henrydatei/cartpole-swingup-rl/latex/input/related_work.tex

\chapter{Background and Literature Review}

\section{Fundamentals of Reinforcement Learning}

Reinforcement learning (RL) is a type of machine learning where an agent learns to make decisions by taking actions in an environment to maximize cumulative reward. This approach is inspired by behaviorist psychology, where learning is achieved through interactions with the environment and is reinforced by rewards and punishments. RL has gained significant attention due to its successful applications in various domains such as robotics, game playing, and autonomous systems (\cite{sutton_reinforcement_2018}).

The fundamental concepts of reinforcement learning are as follows:
\begin{itemize}
    \item Agent and Environment: In RL, the learning process involves an agent and an environment. The agent interacts with the environment by performing actions, and the environment responds by providing feedback in the form of rewards or penalties. The objective of the agent is to learn a policy that maximizes the total reward over time (\cite{sutton_reinforcement_2018}).
    \item State ($S$): Represents the current situation or configuration of the environment.
    \item Action ($A$): The set of all possible moves the agent can make.
    \item Reward ($R$): The feedback from the environment based on the action taken by the agent.
    \item Policy ($\pi$): A policy is a strategy used by the agent to decide the next action based on the current state.
    \item Value Function ($V$): The value function estimates the expected return (total reward) starting from a state and following a particular policy. It helps in evaluating the goodness of states (\cite{szepesvari_algorithms_2022}).
    \item Model-Free RL: The agent learns a policy or value function without understanding the underlying model of the environment. Examples include Q-Learning (\cite{watkins_q-learning_1992}) and PPO (\cite{pan_policy_2018}).
    \item Model-Based RL: The agent learns a model of the environment (transition probabilities and reward function) and uses it to plan actions (\cite{kaelbling_reinforcement_1996}).
\end{itemize}

The key algorithms in reinforcement learning include:
\begin{itemize}
    \item Dynamic Programming: Dynamic programming (DP) methods require a complete model of the environment. They are used to compute optimal policies by iteratively improving value functions. Examples include Policy Iteration and Value Iteration.
    \item Monte Carlo (MC) methods learn directly from episodes of experience. They do not require knowledge of the environment's model and estimate value functions based on sample returns.
    \item Temporal-Difference (TD) learning combines ideas from DP and MC methods. It updates value estimates based on the difference between consecutive estimates (\cite{sutton_reinforcement_2018}).
\end{itemize}

One of the central challenges in RL is the trade-off between exploration (trying new actions to discover their effects) and exploitation (choosing actions that are known to yield high rewards). Various strategies such as $\varepsilon$-greedy, softmax, and Upper Confidence Bound (UCB) are employed to balance this trade-off (\cite{auer_finite-time_2002}).

With the advent of deep learning, RL has evolved into deep reinforcement learning (DRL), where neural networks are used to approximate value functions or policies. Notable advancements include:
\begin{itemize}
    \item Deep Q-Network (DQN): Combines Q-Learning with deep neural networks to handle high-dimensional state spaces, such as those in Atari games (\cite{mnih_human-level_2015}).
    \item Actor-Critic Methods: Use two neural networks, one for the policy (actor) and one for the value function (critic). Examples include A3C (Asynchronous Advantage Actor-Critic) and PPO (Proximal Policy Optimization) (\cite{mnih_asynchronous_2016,schulman_proximal_2017}).
\end{itemize}

The state-of-the-art algorithm is Proximal Policy Optimization (PPO) which is a model-free, on-policy algorithm that optimizes the policy by maximizing the expected return. It uses a clipped surrogate objective to prevent large policy updates and ensure stable learning. PPO has been successfully applied to a wide range of tasks, including robotic manipulation, locomotion, and game playing. It combines the benefits of policy gradient methods with the stability of trust region methods and is implemented in the OpenAI Baselines library (\cite{schulman_proximal_2017,openai_proximal_2017,wouter_van_heeswijk_proximal_2023}).

\section{The Cart-Pole Problem and Swing-Up Dynamics}

The cart-pole problem, often referred to as the inverted pendulum, is a classic benchmark in control theory and reinforcement learning. It involves a pole attached to a cart that moves along a frictionless track. The goal is to balance the pole upright by applying forces to the cart. This problem has been extensively studied because it embodies the fundamental challenges of dynamic stability and control like nonlinearity and instability (\cite{kumari_root_2023}).

The cart-pole system consists of a cart of mass $m_c$ and a pole of length $l$ and mass $m_p$. The cart can move horizontally, and the pole is free to swing in the vertical plane. The system's state can be described by four variables: the cart's position $x$, the cart's velocity $\dot{x}$, the pole's angle $\theta$ from the vertical, and the pole's angular velocity $\dot{\theta}$.

The equations of motion for the cart-pole system are derived from Newton's laws of motion and can be expressed as follows (assuming no friction):
\begin{align}
\ddot{\theta} &= \frac{g\sin\theta + \cos\theta\left(\frac{-F-m_p l \dot{\theta}^2 \sin\theta}{m_c+m_p}\right)}{l\left(\frac{4}{3}-\frac{m_p \cos^2 \theta}{m_c+m_p}\right)} \notag \\
\ddot{x} &= \frac{F+m_p l (\dot{\theta}^2 \sin\theta - \ddot{\theta} \cos\theta)}{m_c+m_p} \notag
\end{align}
where $F$ is the force applied to the cart, and $g$ is the acceleration due to gravity. These equations are coupled and nonlinear, posing a significant challenge for control (\cite{florian_correct_2007}).

While balancing the pole is a standard control problem, the swing-up task involves bringing the pole from a hanging downward position to an upright position and then stabilizing it. The swing-up problem is more complex because it requires controlling the system to pass through a large range of states.

One popular method for solving the swing-up problem is based on energy control. The idea is to apply forces to the cart to increase the total energy of the system to the desired level that allows the pole to be balanced upright. The total energy $E$ of the system is the sum of the kinetic and potential energies:
\begin{align}
E = \frac{1}{2} m_c \dot{x}^2 + \frac{1}{2} m_p (\dot{x}^2 + l^2 \dot{\theta}^2 + 2 l \dot{x} \dot{\theta} \cos(\theta)) + m_p g l \cos(\theta) \notag
\end{align}
The control strategy involves applying a force $F$ to the cart that drives the system's energy towards the desired energy level for the upright position. When the pole's energy is close to the required level, a switching strategy can be employed to transition from swing-up control to balance control (\cite{astrom_swinging_2000}).

\section{Solution Approaches for the Cart-Pole Problem}

Several notable solution approaches have been applied to the Cart-Pole problem, utilizing various control algorithms as highlighted by Kumari and Agarwal (\citeyear{kumari_root_2023}). These include:
\begin{itemize}
    \item PID Controller
    \item Reinforcement Learning
    \item Linear Quadratic Regulator (LQR) Controller
    \item Lyapunov-based Controller
    \item Particle Swarm Optimized Controller
    \item Fuzzy Controller
    \item Sliding Mode Controller
\end{itemize}

These approaches are often combined to achieve optimal results. Furthermore, an exemplary paper is introduced which demonstrates the application of each approach.

\subsection{PID Controller}

The Proportional-Integral-Derivative (PID) controller is a control strategy where the control signal at time $t$ is the sum of the proportional, integral, and derivative components. All three components respond to the error $e_t$, which is the difference between the desired and the actual state:
\begin{itemize}
    \item Proportional (P) Component: Reacts proportionally to the current error.
    \item Integral (I) Component: Responds to the accumulated sum of past errors.
    \item Derivative (D) Component: Reacts to the rate of change of the error.
\end{itemize}
For discrete time, the control signal is given by:
\begin{align}
    u_t = K_P\cdot e_t + K_I\cdot\sum_{i=0}^t e_i + K_D\cdot\frac{e_t - e_{t-1}}{\Delta t} \notag
\end{align}
In continuous time, the derivative term is replaced by the derivative, and the summation term by the integral. The values of $K_P$, $K_I$, and $K_D$ are referred to as the \textit{gains} and are determined through manual tuning or optimization.

Chang and Lee (\citeyear{chang_design_2007}) used three PID controllers: one for the swing-up phase, one for stabilizing the pendulum's angle when it is within $\pm 14^\circ$, and one for balancing the pendulum when it is within $\pm 3^\circ$. The second phase enhances the system's robustness by utilizing Feedback Linearization Control to linearize the nonlinear system. The core idea behind Feedback Linearization Control is to transform the nonlinear system
\begin{align}
    \dot{x} = f(x) + g(x)\cdot u \notag
\end{align}
where $x$ is the state vector, $u$ is the control input, and $f$ and $g$ are nonlinear functions describing the system dynamics. The system is linearized by transforming the control input and introducing a new control signal $v$:
\begin{align}
    u = \frac{1}{g(x)}(v - f(x)) \notag
\end{align}
This results in a linearized system $\dot{x} = v$, which can then be controlled using linear controllers like PID or LQR (\cite{slotine_applied_1991}, p. 208ff).

Comparative studies, such as those by Prasad et al. (\citeyear{prasad_optimal_2011}) and Varghese et al. (\citeyear{varghese_optimal_2017}), have compared PID controllers with other control techniques, frequently in combination with LQR. These studies conclude that while PID performs well, other controllers tend to outperform it. Both studies used MATLAB Simulink for simulations, with a time step of 0.01 seconds and a maximum simulation period of 10 seconds. The system typically reaches equilibrium after approximately 7 seconds. The state-space equations with disturbance input are:
\begin{align}
    \dot{x} &= \frac{\mathrm{d}}{\mathrm{d}t}\begin{pmatrix}
        \theta \\
        \dot{\theta} \\
        z \\
        \dot{z}
    \end{pmatrix} = \begin{pmatrix}
        \dot{\theta} \\
        f_1 \\
        \dot{z} \\
        f_2
    \end{pmatrix} \notag \\
    y &= Cx \notag \\
    f_1 &= \frac{u\cos(\theta) - (M+m)g\sin(\theta) + ml(\cos(\theta)\sin(\theta))\dot{\theta}^2 - \frac{M}{m}F_w\cos(\theta)}{ml\cos^2(\theta) - (M+m)l} \notag \\
    f_2 &= \frac{u + ml(\sin(\theta))\dot{\theta}^2 - mg\cos(\theta)\sin(\theta) + F_w\sin^2(\theta)}{M+m-m\cos^2(\theta)} \notag
\end{align}
where $z$ is the cart position, $\theta$ is the pendulum angle, $M$ is the cart mass, $m$ is the pendulum mass, $l$ is the length of the pendulum, $g$ is gravitational acceleration, $F_w$ represents wind disturbance, and $u$ is the control force applied to the cart. Both studies used two PID controllers: one controlling the cart's position towards the center, and the other balancing the pendulum. The wind disturbance was simulated using a white noise signal.

\subsection{Reinforcement Learning}

For an overview of the theory behind reinforcement learning (RL), refer to the previous section. RL is a technique in which an agent learns to select actions through interactions with the environment to maximize a cumulative reward. By interacting with the environment, the agent gains experience and adjusts its strategy to optimize the reward. To reduce the effort required for modeling the environment, model-free RL is commonly employed, where the agent learns directly from experiences without explicitly modeling the environment.

There are only a few papers that utilize a real cart-pole system for the swing-up task (e.g., \cite{nayante_reinforcement_2021, pilcolearner_cart-pole_2011, deisenroth_pilco_2011}); most studies use simulated environments, often without addressing the swing-up task, and employ similar reward functions (e.g., \cite{kumar_balancing_2020, liu_swing-up_2023, kimura_stochastic_1999}). Various approaches to reward functions are discussed in the Experimental Setup section. Notably, only one recent paper was found that uses a real cart-pole system for the swing-up task, although it applies a simple reward function (\cite{nayante_reinforcement_2021}).

I chose to continue my work with the reinforcement learning (RL) controller due to its unique challenge and potential in real-world applications. Unlike other control strategies, where multiple papers have successfully demonstrated both swing-up and balancing of the pole in real-world scenarios, only one study using an RL-based approach has managed to accomplish this (\cite{nayante_reinforcement_2021}). The limited number of real-world implementations highlights the complexity of applying RL to physical systems, yet it also presents an opportunity for further exploration and innovation. By advancing this line of research, I aim to contribute to the development of RL controllers capable of performing both swing-up and stabilization in practical, real-world environments.

\subsection{LQR Controller}

The Linear Quadratic Regulator (LQR) was introduced by Kalman (\citeyear{kalman_contributions_1960}) and is optimal for linear systems with quadratic cost functions. The dynamics of a linear system are given by:
\begin{align}
    \dot{x} = Ax + Bu \notag
\end{align}
where $x$ is the state vector, $u$ is the control input, and $A$ and $B$ are system matrices. The cost function is defined as:
\begin{align}
    J = \int_0^\infty (x^T Q x + u^T R u) \,\mathrm{d}t \notag
\end{align}
where $Q$ and $R$ are weighting matrices. The goal of LQR is to minimize this cost function by choosing the control law $u = -Kx$, where $K$ is the regulator matrix, ensuring system stability. The matrix $K$ is found by solving the Riccati equation:
\begin{align}
    A^T P + PA - PBR^{-1}B^T P + Q = 0 \notag
\end{align}
Once the solution $P$ is obtained, the regulator matrix $K$ is calculated as:
\begin{align}
    K = R^{-1}B^T P \notag
\end{align}
Solving the Riccati equation guarantees that the regulator stabilizes the system (as long as the system $(A, B)$ is stabilizable) and minimizes the cost function.

Kumar and Jerome (\citeyear{vinodh_kumar_robust_2013}) applied this approach. After analyzing their system, they determined the following system matrices:
\begin{align}
    A &= \begin{pmatrix}
        0 & 0 & 1 & 0 \\
        0 & 0 & 0 & 1 \\
        0 & \frac{(M_pl)^2}{q} & \frac{-B_{eq}(M_pl^2 + I)}{q} & \frac{M_plB_p}{q} \\
        0 & \frac{(M+M_p)M_pgl}{q} & \frac{M_plB_{eq}}{q} & \frac{(M+M_p)B_p}{q}
    \end{pmatrix} \notag \\
    B &= \begin{pmatrix}
        0 \\
        0 \\
        \frac{M_pl^2+I}{q} \\
        \frac{M_pl}{q}
    \end{pmatrix} \notag \\
    x &= \begin{pmatrix}
        z \\
        \theta \\
        \dot{z} \\
        \dot{\theta}
    \end{pmatrix} \notag
\end{align}
Here, $M_p$ and $l$ are the mass and length of the pendulum, $M$ is the mass of the cart, $I$ is the moment of inertia of the pendulum, $B_{eq}$ is the equivalent damping constant, $B_p$ is the pendulum damping constant, $g$ is gravitational acceleration, $z$ is the cart position, and $\theta$ is the pendulum angle. The term $q$ is defined as: $q = (M+M_p)(I+M_pl^2) - (M_pl)^2$. With the following weighting matrices:
\begin{align}
    Q &= \begin{pmatrix}
        0.5 & 0 & 0 & 0 \\
        0 & 5.5 & 0 & 0 \\
        0 & 0 & 0 & 0 \\
        0 & 0 & 0 & 0
    \end{pmatrix} \notag \\
    R &= \begin{pmatrix}
        0.0003
    \end{pmatrix} \notag
\end{align}
the regulator matrix $K$ is found to be:
\begin{align}
    K = \begin{pmatrix}
        -44.72 & 200.8 & -49.77 & 27.38
    \end{pmatrix} \notag
\end{align}
for the system that Kumar and Jerome built in their laboratory. The system reaches equilibrium after approximately 7 seconds.

\subsection{Lyapunov-based Controller}

Lyapunov-based control is a method used to design controllers that ensure system stability by employing Lyapunov functions. A Lyapunov function is a scalar function that quantifies the system's energy and is used to assess its stability. The Lyapunov function is chosen such that its derivative along the system's trajectories is negative definite, guaranteeing that the system converges to a stable equilibrium point. (\cite{slotine_applied_1991}).

Kai and Bito (\citeyear{kai_new_2014}) combined a Lyapunov function with an LQR controller to solve the Cart-Pole problem through simulation. Additionally, they used discrete mechanics, which present fewer numerical errors while preserving some physical laws and allowing for larger sampling times (\cite{marsden_discrete_2001}). Their method successfully balanced the pole upright after 3.2 seconds. The Lyapunov function they used is:
\begin{align}
    V_k = w_1E_k^2 + w_2\left((\cos\theta_k-1)^2 + \sin^2\theta_k\right) + w_3(\theta_{k-1} - \theta_k)^2 + w_4z_k^2 \notag
\end{align}
where $w_1, w_2, w_3, w_4 > 0$ are weights, $\theta_k$ is the angle of the pole at time step $k$, $z_k$ is the position of the cart at time step $k$, and $E_k$ is a discrete energy-like function defined as:
\begin{align}
    E_k = \frac{1}{2}ml^2\left(\frac{\theta_k - \theta_{k-1}}{h}\right)^2 + mgl[\cos((1-\alpha)\theta_{k-1} + \alpha\theta_k) - 1] \notag
\end{align}
where $m$ is the mass, $l$ is the length of the pendulum, and $h$ is the sampling interval. The parameter $\alpha$ is a weighting factor between consecutive angles. A correction function $\Gamma(\theta_{k+1}, u_k)$ is introduced, which becomes zero when the optimal control input $u_k$ and the next state $\theta_{k+1}$ are substituted:
\begin{align}
    \Gamma(\theta_{k+1}, u_k) = V_{k+1} - V_k + p(\theta_k - \theta_{k-1})^2 = 0 \notag
\end{align}
Here, $p$ is a weight, and the Lyapunov function $V_k$ depends on the system state, thereby indirectly depending on $u_k$. Using the Newton method and the following update rule:
\begin{align}
    u_{k}^{l+1} = u_k^l - \frac{\partial\Gamma}{\partial u_k}^{-1}\Gamma \notag
\end{align}
the optimal control input $u_k$ is iteratively found. For stabilization, the LQR controller is activated when the pendulum's angle reaches $\frac{\pi}{4}$ radians.

\subsection{PSO Controller}

The tuning of controller parameters is often performed through trial and error or optimization algorithms. One such optimization algorithm is Particle Swarm Optimization (PSO). PSO was introduced by James Kennedy and Russell Eberhart in 1995, inspired by the social behavior of birds flocking or fish schooling. The core idea of PSO is to simulate the social dynamics of a group of individuals, called particles, that collaboratively search for the optimal solution to a problem. In this algorithm, each particle represents a potential solution. These particles move through the solution space and adjust their positions based on their own experiences and the experiences of neighboring particles (\cite{kennedy_discrete_1997}). Each particle has a position and a velocity, which are iteratively updated based on three key influences: the particle's current position, its personal best position, and the global best position discovered by the swarm (\cite{eberhart_new_1995}).

Initially, a swarm of particles is randomly positioned within the search space, and their velocities are randomly assigned (\cite{shi_parameter_1998}). The fitness of each particle, indicating its closeness to the optimal solution, is evaluated using an objective function. To improve their positions, particles update their velocities by considering three factors: their inertia (current velocity), the cognitive influence (direction towards their personal best position), and the social influence (direction towards the global best position) (\cite{eberhart_new_1995}). These updates guide the particles' movement through the solution space, and over time, they converge towards better solutions. Each particle's personal best is updated whenever it finds a better position, and the global best is updated if any particle discovers a new overall best position. This process repeats until a stopping criterion is met, such as reaching a maximum number of iterations or finding a sufficiently good solution (\cite{angeline_evolutionary_1998}). Random factors are included to introduce variability into the search, while certain parameters control the strength of the pull towards the personal and global best positions (\cite{ozcan_analysis_1998}).

Mousa et al. (\citeyear{mousa_stabilizing_2015}) compared a PI controller with LQR against a PI controller optimized using PSO and found that the PSO-optimized PI controller outperformed the PI+LQR controller. In their simulations, the pendulum balanced in 6 seconds with the PI+LQR controller, while it balanced in only 4 seconds using the PSO-optimized PI controller.

\subsection{Fuzzy Controller}

A fuzzy logic controller is a type of control system that uses fuzzy logic, instead of traditional binary logic, to handle uncertain, imprecise, or ambiguous data. Unlike conventional controllers that rely on precise inputs and mathematical models, a fuzzy logic controller mimics human decision-making by interpreting inputs in a way that resembles natural language reasoning (\cite{rehman_introduction_2017}). This makes it particularly useful for complex systems where exact mathematical models are difficult to derive, or where control needs to manage vagueness.

The basic operation of a fuzzy logic controller involves three main stages: fuzzification, inference, and defuzzification. In the fuzzification stage, precise input values are converted into fuzzy sets. These sets represent linguistic variables like \textit{low}, \textit{medium}, or \textit{high}, using membership functions that define the degree to which a particular input belongs to each category (\cite{liu_real-time_2009}).

The next stage is the inference process, where fuzzy sets are applied to a set of if-then rules to determine the control action. These rules are based on expert knowledge and are expressed in simple, human-like terms (\cite{dahiya_introduction_2016}). Multiple rules can be applied simultaneously, and the system combines them to determine the most appropriate control output.

In the final stage, defuzzification, the fuzzy results from the inference process are converted back into precise values to produce a specific control action (\cite{mahmoud_basics_2018}, pp. 15ff).

Nour et al. (\citeyear{nour_fuzzy_2007}) employed a fuzzy logic controller to balance a simulated Cart-Pole system. In their setup, the pole starts in the upright position and is only destabilized by external disturbances. The control objective is to move the cart in such a way that the pole returns to its upright position. The fuzzy logic controller was compared with a PID controller, showing superior performance. Specifically, the PID controller's parameters were optimized for one set of system parameters (1-kilogram cart, 100-gram pole), but when applied to a system with different parameters, the fuzzy logic controller demonstrated greater robustness. For their fuzzy logic controller, they defined 5 fuzzy sets for the pole's angle, 5 fuzzy sets for the angular velocity, 2 fuzzy sets for the cart's position and velocity, and 13 fuzzy sets for the force to be applied to the cart. A total of 225 rules were established to determine the force, based on the following formula and the fuzzy sets into which the input values fall:
\begin{align}
    F = \theta + (\dot{\theta}-1) + (-x+3) + (-\dot{x}+3) \notag
\end{align}
In a subsequent step, the number of rules was reduced to 16, with only 2 fuzzy sets (positive or negative) for each of the 4 inputs. This reduction in rule complexity decreased the computation time while still providing satisfactory results.

\subsection{Sliding Mode Controller}

A sliding mode controller (SMC) is a nonlinear control method designed to drive a system's state to a predefined surface, called the sliding surface, and to keep it on that surface indefinitely. This control strategy is particularly effective for systems with uncertainties or disturbances, as it offers robust performance by switching the control law based on the system's state (\cite{edwards_sliding_1998}).

The operation of an SMC is divided into two phases: the reaching phase and the sliding phase (\cite{uswarman_robust_2019}). In the reaching phase, the controller drives the system's state to the sliding surface. Once the state reaches the surface, the sliding phase begins, during which the system state moves along the surface to the desired equilibrium point. The sliding surface is designed such that the system's behavior on the surface satisfies the control objectives (\cite{maarif_sliding_2022}).

A key feature of SMC is its robustness to disturbances and model uncertainties. This robustness arises because, once the system enters the sliding mode, the dynamics are governed by the sliding surface, making them independent of certain types of disturbances or parameter variations. However, the switching behavior of the control signal can result in a phenomenon called chattering, where rapid switching of the control signal occurs, which can be undesirable in practical applications. To mitigate chattering, various techniques, such as introducing a boundary layer around the sliding surface, are employed to smooth the control actions (\cite{chalanga_output_2019}).

Mathematically, the control law in SMC typically includes a discontinuous component that switches the control action depending on the system's position relative to the sliding surface (\cite{mahmoud_optimizing_2021}). The design of the sliding surface is critical, as it directly impacts the system's performance during the sliding phase.

Ma'arif et al. (\citeyear{maarif_backstepping_2022}) extended this controller using the backstepping technique, which divides a complex system into subsystems. Their simulation focused only on balancing the pendulum and did not include the swing-up phase. They used the following nonlinear model:
\begin{align}
    \dot{\theta} &= f(x,t) + g(x,t)u + d(x,t) \notag
\end{align}
where $\theta$ is the pendulum's angle, $x$ is a vector consisting of $\theta$ and $\dot{\theta}$, $u$ is the force applied to the cart, and $d(x,t)$ represents a disturbance. The functions $f(x,t)$ and $g(x,t)$ describe the system dynamics:
\begin{align}
    f(x,t) &= \frac{g\sin(\theta) - \frac{ml\dot{\theta}^2\cos(\theta)\sin(\theta)}{m_c+m}}{l\left(\frac{4}{3}-\frac{m\cos^2(\theta)}{m_c+m}\right)} \notag \\
    g(x,t) &= \frac{\frac{\cos(\theta)}{m_c+m}}{l\left(\frac{4}{3}-\frac{m\cos^2(\theta)}{m_c+m}\right)} \notag
\end{align}
where $m_c$ is the mass of the cart, $m$ is the mass of the pendulum, $l$ is the length of the pendulum, and $g$ is gravitational acceleration (\cite{valluru_stabilization_2017}). Ma'arif et al. (\citeyear{maarif_backstepping_2022}) defined an error function $e = \theta_d - \theta$, where $\theta_d$ is the desired angle, and designed a sliding surface $s = \dot{e} + c e$ with $c$ a positive constant. Using the Lyapunov function $V=\frac{1}{2}s^2$, they demonstrated that $\dot{V}<0$, proving the system's stability. They then designed a control law:
\begin{align}
    u = g(x,t)^{-1}(-f(x,t) +\ddot{\theta_d} + c\dot{e} + \eta\text{sgn}(s)) \notag
\end{align}
to stabilize the system, where $\text{sgn}(\cdot)$ is the signum function and $\eta$ is a variable introduced to reduce small oscillations in the system's response. The authors set the value of $\eta$ to 0.03 and later to 0.05, achieving stabilization in less than 1 second after the system was disturbed. This method also worked when system parameters, such as mass or length, were changed.
