henrydatei/cartpole-swingup-rl/latex/input/results_and_discussion.tex

\chapter{Results and Discussion}

\section{Results of the Experiments}

\subsection{First Set of Experiments: Determining the Angle}
In these experiments, an RL agent was not yet employed; instead, the detected angles were directly displayed on the screen to verify angle determination. A significant problem with detecting the colored rectangles on the pendulum and the piece of plastic was that sunlight altered the colors, causing the color detection to fail, particularly with the violet color, which was especially affected.

This issue was resolved by attaching symbols, which do not change color. Despite extensive calibration and testing various forms (printed vs. hand-drawn), reliable detection was not possible. Too many elements in the image, such as screws or background objects (people passing by, chairs, etc.), were detected, often mistakenly as circles. Filtering using OpenCV's \texttt{moments()} function did not provide reliable detection either.

Detection of circles using the Hough Circle Transformation showed that while triangle detection was fairly reliable, circle detection remained highly error-prone. Often, circles were not recognized. Given that this function yields good results in various sources, it is suspected that the camera image contains too much noise.

The improved approach to color detection yielded reliable angle measurements.

\subsection{Second Set of Experiments: Optimizing Hardware}
Making the pendulum lighter did not help: Although a lighter pendulum required less force to lift, its inertia was insufficient to lift the pendulum upwards.

At high currents (1.51 A RMS, 2.14 A Peak and 2 A RMS, 2.83 A Peak), the stepper motor became very hot, necessitating the installation of a fan to cool the motor. One of the two stepper motors from stepperonline was not accurate; the position calculated by the Arduino did not match the actual position of the cart. Low currents with this motor did not improve its accuracy. The other stepper motor from stepperonline was accurate, even at high currents. Experiments with various currents identified an RMS current of 1.2 A (Peak 1.69 A) as a good trade-off between motor force and overheating for the stepper motor from stepperonline. The fan can then be operated at 3.3V and is relatively quiet.

Findings from experiments with maximum speed: The higher the speed chosen for the stepper motor, the lower the accuracy. Various experiments determined a maximum speed of 60,000 steps/second at which the motor remained accurate. The maximum acceleration was found to be 1,000,000 steps/second$^2$, at which the motor was still accurate. At higher values, the stepper motor was unable to execute all the steps sent to it, resulting in reduced accuracy.

\subsection{Third Set of Experiments: Optimizing Software}
Using the FIFO queue resulted in less extreme values for angular velocity, as shown in Figure \ref{fig:before_after_smoothing}. The values before smoothing reached approximately 700 rad/s, with outliers up to 1400 rad/s. After smoothing over the last 3 angles, the values were at a maximum of 400 rad/s.
\begin{figure}[htbp]
    \centering
    
    
    \caption{Comparison of the angle speed with and without the FIFO-Queue of Length 3}
    \label{fig:before_after_smoothing}
\end{figure}
The use of the flag, which is set to 1 when the pole is upright, to distinguish whether the angle and angular velocity are zero because the pole is upright or because the RL agent is retrieving messages from the camera faster than new angles can be determined, was successful. Without this error correction, this issue occurred in a dataset at 85 out of 10240 observations (0.83\%).

Comparing different action spaces, it is evident that the size of the action space does not affect performance under different reward functions. In Figure \ref{fig:action_space_comparison}, the mean reward per episode over a window of 100 episodes is shown for the reward functions $r_{highVelocity}$, $r_{simple}$ and $r_{complex}$ with $\alpha=5$, $\beta=1$, $\gamma=1$ and $\delta=0$, and action space sizes of 101 actions, 51 actions, and 2 actions. The reward function converges after approximately 200,000 steps no matter what reward function or size of the action space. As simpler models are generally preferable to more complex ones, a discrete action space with 2 actions is used for further experiments.
\begin{figure}[htbp]
    \centering
    
    
    
    \caption{Comparison of the convergence of the mean reward per episode for different reward functions and action spaces}
    \label{fig:action_space_comparison}
\end{figure}
Observing the RL agent, it quickly became apparent that without using time.sleep(0.1), the RL agent cannot lift the pendulum because it performs too many actions, causing the cart to move back and forth quickly over short distances. This does not allow the pendulum to build momentum, which is necessary for swinging upwards. However, with increased training time, it is conceivable that the RL agent could learn this on its own. Many quick actions are then needed in the balancing phase.

The simple reward function does not lead to the desired behavior; the observed angles are often very large ($\pm\pi$, corresponding to the downward position of the pendulum), as seen in Figure \ref{fig:angle_simple_reward}. The white area at $\pm 1$ radian occurs because the camera cannot see any side of the pendulum when it is horizontal. Therefore, angles cannot be measured in this state. The observed angular velocity is often very high, indicating that the pendulum swings very quickly. While this can lift the pendulum upwards, it is very difficult to balance it at the top (see Figure \ref{fig:angle_velocity_simple_reward}). The mean reward per episode converges to around -1600 (see Figure \ref{fig:mean_reward_simple_reward}).
\begin{figure}[htbp]
    \centering
    
    \caption{Seen angles of the pendulum over 200000 steps with the simple reward function}
    \label{fig:angle_simple_reward}
\end{figure}
\begin{figure}[htbp]
    \centering
    
    \caption{Seen angular velocities of the pendulum over 200000 steps with the simple reward function}
    \label{fig:angle_velocity_simple_reward}
\end{figure}
\begin{figure}[htbp]
    \centering
    
    \caption{Mean reward per episode with the simple reward function}
    \label{fig:mean_reward_simple_reward}
\end{figure}

The reward function proposed by Kimura \& Kobayashi (\citeyear{kimura_stochastic_1999}) also did not yield good performance. Although the mean reward stabilized (see Figure \ref{fig:mean_reward_kimura1999}), the angles never reached 0 radians, meaning no swing-up occurred (see Figure \ref{fig:angle_kimura1999}). The observed angular velocity significantly decreased over time (see Figure \ref{fig:angle_velocity_kimura1999}).
\begin{figure}[htbp]
    \centering
    
    \caption{Seen angles of the pendulum over 200000 steps with the reward function of Kimura \& Kobayashi (\citeyear{kimura_stochastic_1999})}
    \label{fig:angle_kimura1999}
\end{figure}
\begin{figure}[htbp]
    \centering
    
    \caption{Seen angular velocities of the pendulum over 200000 steps with the reward function of Kimura \& Kobayashi (\citeyear{kimura_stochastic_1999})}
    \label{fig:angle_velocity_kimura1999}
\end{figure}
\begin{figure}[htbp]
    \centering
    
    \caption{Mean reward per episode with the reward function of Kimura \& Kobayashi (19\citeyear{kimura_stochastic_1999}99)}
    \label{fig:mean_reward_kimura1999}
\end{figure}

The reward function proposed by Escobar et al. (\citeyear{manrique_escobar_parametric_2020}) also did not lead to success. The observed angles did not converge to 0 radians, as shown in Figure \ref{fig:angle_escobar2020}. The observed angular velocities (Figure \ref{fig:angle_velocity_escobar2020}) were comparable to those observed with the simple reward function. The achieved reward was numerically higher but decreasing (Figure \ref{fig:mean_reward_escobar2020}).
\begin{figure}[htbp]
    \centering
    
    \caption{Seen angles of the pendulum over 200000 steps with the reward function of Escobar et al (\citeyear{manrique_escobar_parametric_2020})}
    \label{fig:angle_escobar2020}
\end{figure}
\begin{figure}[htbp]
    \centering
    
    \caption{Seen angular velocities of the pendulum over 200000 steps with the reward function of Escobar et al (\citeyear{manrique_escobar_parametric_2020})}
    \label{fig:angle_velocity_escobar2020}
\end{figure}
\begin{figure}[htbp]
    \centering
    
    \caption{Mean reward per episode with the reward function of Escobar et al (\citeyear{manrique_escobar_parametric_2020})}
    \label{fig:mean_reward_escobar2020}
\end{figure}

The reward function that rewards high angular velocity during the swing-up phase,$r_{highVelocity}$, was also unsuccessful. The observed angles did not converge to 0 radians, as shown in Figure \ref{fig:angle_swingup}. The observed angular velocities (Figure \ref{fig:angle_velocity_swingup}) were comparable to those observed with other reward functions. The achieved reward increased but had not yet reached its previous maximum after around 40,000 timesteps. At this point, more angles around 0 radians were observed, but many angles were still observed at $\pm\pi$ radians (Figure \ref{fig:mean_reward_swingup}). Therefore, the reward could potentially increase significantly.
\begin{figure}[htbp]
    \centering
    
    \caption{Seen angles of the pendulum over 200000 steps with the high velocity reward function}
    \label{fig:angle_swingup}
\end{figure}
\begin{figure}[htbp]
    \centering
    
    \caption{Seen angular velocities of the pendulum over 200000 steps with the high velocity reward function}
    \label{fig:angle_velocity_swingup}
\end{figure}
\begin{figure}[htbp]
    \centering
    
    \caption{Mean reward per episode with the high velocity reward function}
    \label{fig:mean_reward_swingup}
\end{figure}

The complex reward function also did not perform well in various scenarios. To simplify the reward function, the negative rewards were initially deactivated, and the reward for the angle was increased using the exponential function compared to the simple reward function. Unfortunately, this did not work; the observed angles still often reached $\pm\pi$ radians, as shown in Figure \ref{fig:angle_ankit_200k_only_angle_reward}. The observed angular velocities (Figure \ref{fig:angle_velocity_ankit_200k_only_angle_reward}) were comparable to those observed with other reward functions. The achieved reward reached its maximum at around 100,000 timesteps, after which it slightly decreased (Figure \ref{fig:mean_reward_ankit_200k_only_angle_reward}).
\begin{figure}[htbp]
    \centering
    
    \caption{Seen angles of the pendulum over 200000 steps with the complex reward function ($\alpha=2$, $\beta=0$, $\gamma=0$, $\delta=0$)}
    \label{fig:angle_ankit_200k_only_angle_reward}
\end{figure}
\begin{figure}[htbp]
    \centering
    
    \caption{Seen angular velocities of the pendulum over 200000 steps with the complex reward function ($\alpha=2$, $\beta=0$, $\gamma=0$, $\delta=0$)}
    \label{fig:angle_velocity_ankit_200k_only_angle_reward}
\end{figure}
\begin{figure}[htbp]
    \centering
    
    \caption{Mean reward per episode with the complex reward function ($\alpha=2$, $\beta=0$, $\gamma=0$, $\delta=0$)}
    \label{fig:mean_reward_ankit_200k_only_angle_reward}
\end{figure}
Activating the position penalty ($\beta=1$ or $\beta=0.1$) stabilizes the mean reward over time. However, observing the Cartpole shows that the cart remains in the center and makes no attempts to swing the pendulum upwards (Figure \ref{fig:angle_position_ankit_200k_position_penalty}). With $\beta=0.1$, the effect is less pronounced. While the pendulum is still not reliably balanced, the cart tends to stay in the center (Figure \ref{fig:angle_position_ankit_200k_weaker_position_penalty}).
\begin{figure}[htbp]
    \centering
    
    
    \caption{Seen angles and positions of the pendulum over 200000 steps with the complex reward function ($\alpha=2$, $\beta=1$, $\gamma=1$, $\delta=0$)}
    \label{fig:angle_position_ankit_200k_position_penalty}
\end{figure}
\begin{figure}[htbp]
    \centering
    
    
    \caption{Seen angles and positions of the pendulum over 200000 steps with the complex reward function ($\alpha=2$, $\beta=0.1$, $\gamma=1$, $\delta=0$)}
    \label{fig:angle_position_ankit_200k_weaker_position_penalty}
\end{figure}
Activating the no swing-up penalty ($\delta=1$) did not change the behavior of the RL agent but resulted in significantly negative rewards (Figure \ref{fig:mean_reward_ankit_1m_no_swing_up_penalty}). Consequently, this penalty was deactivated again.
\begin{figure}[htbp]
    \centering
    
    \caption{Mean reward per episode with the complex reward function ($\alpha=2$, $\beta=1$, $\gamma=1$, $\delta=1$)}
    \label{fig:mean_reward_ankit_1m_no_swing_up_penalty}
\end{figure}
The influence of the angular velocity penalty ($\gamma=1$) resulted in slightly better outcomes. Comparing the angular velocities when the angle is at $\pm 12^\circ$, there is a higher count of angular velocities with $\gamma=1$ (2209 vs. 1377 over 200,000 steps), indicating that the pole was balanced for a longer duration. However, the observed angular velocities did not become significantly smaller (Figure \ref{fig:filtered_angular_velocity_ankit_200k_compare_angular_velocity_penalty}).
\begin{figure}[htbp]
    \centering
    
    
    \caption{Comparision of seen angular velocities of the pendulum over 200000 steps with the complex reward function ($\alpha=2$, $\beta=0.1$, $\delta=0$) when seen angle is between $\pm$ 12$^\circ$}
    \label{fig:filtered_angular_velocity_ankit_200k_compare_angular_velocity_penalty}
\end{figure}
Even with a longer training time of 1 million steps, the pole could not be reliably balanced (compare Figure \ref{fig:mean_reward_ankit_200k_only_angle_reward} with Figure \ref{fig:mean_reward_ankit_1m_only_angle_reward}).
\begin{figure}[htbp]
    \centering
    
    \caption{Mean reward per episode with the complex reward function ($\alpha=2$, $\beta=0$, $\gamma=0$, $\delta=0$)}
    \label{fig:mean_reward_ankit_1m_only_angle_reward}
\end{figure}

\section{Challenges and Limitations of Experiments}

Since this is a real system and not a simulation, many challenges arise that do not occur in simulations. These include real-time detection of the pendulum angles, various delays caused by the hardware, and accurate determination of angular velocity: angle change divided by very short time intervals results in a large error, even with small time deviations. Smoothing should mitigate this effect.

To determine the camera delay, the current time was recorded before capturing the image and compared with the time when the angle calculation was completed. The camera and image processing delay fluctuates around 0.1 seconds, and the total delay of all components fluctuates around 0.2 seconds, with extreme cases reaching 0.7 seconds (see Figure \ref{fig:camera_delay_boxplot}). For comparison, the previous experimental setup had a delay of about 0.2 seconds. In this setup, image capture and evaluation were executed synchronously in each step, but the image processing is quite similar.
\begin{figure}
    \centering
    
    \caption{Boxplot of the Camera Delay and Image Processing (labeled as Camera Delay) and the Total Delay of all Components (labeled as Total Delay) with improvements. For comparison the Total Delay without improvements is also shown, labeled as Old System.}
    \label{fig:camera_delay_boxplot}
\end{figure}
Over time, the overall delay seems to increase, and outliers become more frequent (see Figure \ref{fig:total_delay_over_time}). It is unclear why this occurs, and it is also unexplained why the image processing script, in many experiments, did not crash but stopped delivering data after about 1.3 million steps.
\begin{figure}
    \centering
    
    \caption{Delay of the Camera and Image Processing for each Observation}
    \label{fig:total_delay_over_time}
\end{figure}
