henrydatei/cartpole-swingup-rl/inverse_cartpole_queue.py

from CartPoleEnv2 import CartPoleEnv2
from CartPoleEnv2_1 import CartPoleEnv2 as CartPoleEnv2_1
from CartPoleEnv2_2 import CartPoleEnv2 as CartPoleEnv2_2
from CartPoleEnv2_3 import CartPoleEnv2 as CartPoleEnv2_3
from CartPoleEnv2_4 import CartPoleEnv2 as CartPoleEnv2_4
from stable_baselines3 import PPO
from stable_baselines3.common.logger import configure
import datetime
import os
import pandas as pd

###########
# CartPoleEnv2
###########

# model_name = "PPO_CartPoleEnv2_200k_smoothing_error_protection_reward_simple_2step_faster_lessweight_2actions_" + datetime.datetime.now().strftime("%Y-%m-%d_%H-%M-%S")
# log_dir = os.path.join("logs", model_name)
# os.makedirs(log_dir, exist_ok=True)
# os.makedirs('models', exist_ok=True)

# myEnv = CartPoleEnv2()
# myEnv.log_dir = log_dir

# new_logger = configure(log_dir,['stdout','csv', 'tensorboard'])
# model = PPO("MlpPolicy", myEnv, verbose=1)
# model.set_logger(new_logger)
# model.learn(total_timesteps=200000)

# myEnv.reset()

# # save model with current time
# model.save(os.path.join("models", model_name))

# # check if file exists and if yes, delete it
# if os.path.isfile(os.path.join(log_dir, 'observations_rewards_times.csv')): 
#     os.remove(os.path.join(log_dir, 'observations_rewards_times.csv'))

# # save observations and rewards
# observations = pd.DataFrame(myEnv.all_observations, columns=['angle1','angle2', 'angle3', 'angle4', 'angle5', 'angle_velocity', 'position', 'position_velocity', 'pole_up'])
# rewards = pd.DataFrame(myEnv.all_rewards, columns=['reward'])
# times = pd.DataFrame(myEnv.all_times, columns=['time'])
# delays = pd.DataFrame(myEnv.all_delays, columns=['delay'])

# # merge observations, rewards and times
# observations = pd.concat([observations, rewards], axis=1)
# observations = pd.concat([observations, times], axis=1)
# observations = pd.concat([observations, delays], axis=1)
# observations.to_csv(os.path.join(log_dir, 'observations_rewards_times.csv'))




# ###########
# # CartPoleEnv2_1
# ###########

# model_name = "PPO_CartPoleEnv2_200k_smoothing_error_protection_reward_escobar_2step_faster_lessweight_2actions_" + datetime.datetime.now().strftime("%Y-%m-%d_%H-%M-%S")
# log_dir = os.path.join("logs", model_name)
# os.makedirs(log_dir, exist_ok=True)
# os.makedirs('models', exist_ok=True)

# myEnv = CartPoleEnv2_1()
# myEnv.log_dir = log_dir

# new_logger = configure(log_dir,['stdout','csv', 'tensorboard'])
# model = PPO("MlpPolicy", myEnv, verbose=1)
# model.set_logger(new_logger)
# model.learn(total_timesteps=200000)

# myEnv.reset()

# # save model with current time
# model.save(os.path.join("models", model_name))

# # check if file exists and if yes, delete it
# if os.path.isfile(os.path.join(log_dir, 'observations_rewards_times.csv')): 
#     os.remove(os.path.join(log_dir, 'observations_rewards_times.csv'))

# # save observations and rewards
# observations = pd.DataFrame(myEnv.all_observations, columns=['angle1','angle2', 'angle3', 'angle4', 'angle5', 'angle_velocity', 'position', 'position_velocity', 'pole_up'])
# rewards = pd.DataFrame(myEnv.all_rewards, columns=['reward'])
# times = pd.DataFrame(myEnv.all_times, columns=['time'])
# delays = pd.DataFrame(myEnv.all_delays, columns=['delay'])

# # merge observations, rewards and times
# observations = pd.concat([observations, rewards], axis=1)
# observations = pd.concat([observations, times], axis=1)
# observations = pd.concat([observations, delays], axis=1)
# observations.to_csv(os.path.join(log_dir, 'observations_rewards_times.csv'))






###########
# CartPoleEnv2_2
###########

# model_name = "PPO_CartPoleEnv2_200k_smoothing_error_protection_reward_kimura_2step_faster_lessweight_2actions_" + datetime.datetime.now().strftime("%Y-%m-%d_%H-%M-%S")
# log_dir = os.path.join("logs", model_name)
# os.makedirs(log_dir, exist_ok=True)
# os.makedirs('models', exist_ok=True)

# myEnv = CartPoleEnv2_2()
# myEnv.log_dir = log_dir

# new_logger = configure(log_dir,['stdout','csv', 'tensorboard'])
# model = PPO("MlpPolicy", myEnv, verbose=1)
# model.set_logger(new_logger)
# model.learn(total_timesteps=200000)

# myEnv.reset()

# # save model with current time
# model.save(os.path.join("models", model_name))

# # check if file exists and if yes, delete it
# if os.path.isfile(os.path.join(log_dir, 'observations_rewards_times.csv')): 
#     os.remove(os.path.join(log_dir, 'observations_rewards_times.csv'))

# # save observations and rewards
# observations = pd.DataFrame(myEnv.all_observations, columns=['angle1','angle2', 'angle3', 'angle4', 'angle5', 'angle_velocity', 'position', 'position_velocity', 'pole_up'])
# rewards = pd.DataFrame(myEnv.all_rewards, columns=['reward'])
# times = pd.DataFrame(myEnv.all_times, columns=['time'])
# delays = pd.DataFrame(myEnv.all_delays, columns=['delay'])

# # merge observations, rewards and times
# observations = pd.concat([observations, rewards], axis=1)
# observations = pd.concat([observations, times], axis=1)
# observations = pd.concat([observations, delays], axis=1)
# observations.to_csv(os.path.join(log_dir, 'observations_rewards_times.csv'))




# ###########
# # CartPoleEnv2_3
# ###########

# model_name = "PPO_CartPoleEnv2_200k_smoothing_error_protection_reward_swing_up_stabilization_2step_faster_lessweight_2actions_" + datetime.datetime.now().strftime("%Y-%m-%d_%H-%M-%S")
# log_dir = os.path.join("logs", model_name)
# os.makedirs(log_dir, exist_ok=True)
# os.makedirs('models', exist_ok=True)

# myEnv = CartPoleEnv2_3()
# myEnv.log_dir = log_dir

# new_logger = configure(log_dir,['stdout','csv', 'tensorboard'])
# model = PPO("MlpPolicy", myEnv, verbose=1)
# model.set_logger(new_logger)
# model.learn(total_timesteps=200000)

# myEnv.reset()

# # save model with current time
# model.save(os.path.join("models", model_name))

# # check if file exists and if yes, delete it
# if os.path.isfile(os.path.join(log_dir, 'observations_rewards_times.csv')): 
#     os.remove(os.path.join(log_dir, 'observations_rewards_times.csv'))

# # save observations and rewards
# observations = pd.DataFrame(myEnv.all_observations, columns=['angle1','angle2', 'angle3', 'angle4', 'angle5', 'angle_velocity', 'position', 'position_velocity', 'pole_up'])
# rewards = pd.DataFrame(myEnv.all_rewards, columns=['reward'])
# times = pd.DataFrame(myEnv.all_times, columns=['time'])
# delays = pd.DataFrame(myEnv.all_delays, columns=['delay'])

# # merge observations, rewards and times
# observations = pd.concat([observations, rewards], axis=1)
# observations = pd.concat([observations, times], axis=1)
# observations = pd.concat([observations, delays], axis=1)
# observations.to_csv(os.path.join(log_dir, 'observations_rewards_times.csv'))





###########
# CartPoleEnv2_4
###########

model_name = "PPO_CartPoleEnv2_200k_smoothing_error_protection_reward_ankit_2step_faster_lessweight_2actions_" + datetime.datetime.now().strftime("%Y-%m-%d_%H-%M-%S")
log_dir = os.path.join("logs", model_name)
os.makedirs(log_dir, exist_ok=True)
os.makedirs('models', exist_ok=True)

myEnv = CartPoleEnv2_4()
myEnv.log_dir = log_dir

new_logger = configure(log_dir,['stdout','csv', 'tensorboard'])
model = PPO("MlpPolicy", myEnv, verbose=1)
model.set_logger(new_logger)
model.learn(total_timesteps=200000)

myEnv.reset()

# save model with current time
model.save(os.path.join("models", model_name))

# check if file exists and if yes, delete it
if os.path.isfile(os.path.join(log_dir, 'observations_rewards_times.csv')): 
    os.remove(os.path.join(log_dir, 'observations_rewards_times.csv'))

# save observations and rewards
observations = pd.DataFrame(myEnv.all_observations, columns=['angle1','angle2', 'angle3', 'angle4', 'angle5', 'angle_velocity', 'position', 'position_velocity', 'pole_up'])
rewards = pd.DataFrame(myEnv.all_rewards, columns=['reward'])
times = pd.DataFrame(myEnv.all_times, columns=['time'])
delays = pd.DataFrame(myEnv.all_delays, columns=['delay'])

# merge observations, rewards and times
observations = pd.concat([observations, rewards], axis=1)
observations = pd.concat([observations, times], axis=1)
observations = pd.concat([observations, delays], axis=1)
observations.to_csv(os.path.join(log_dir, 'observations_rewards_times.csv'))
