henrydatei/cartpole-swingup-rl/(commit log)

2024-04-25 inital code upload
    [observations.csv, observations_rewards_times.csv, progress.csv, rewards.csv]
2024-04-25 neuer motor
    [observations_rewards_times.csv, progress.csv]
2024-04-25 kühlung an motor
    [progress.csv]
2024-04-30 1.5m training
    [progress.csv]
2024-04-30 ankits reward funktion
    [progress.csv]
2024-04-30 3 actions
    [progress.csv]
2024-04-30 Kabelsalat behoben
    [progress.csv]
2024-04-30 viel rumprobieren
    [observations_rewards_times.csv, progress.csv]
2024-05-02 git lfs? + 600k training
    [observations.csv, observations_rewards_times.csv, progress.csv, rewards.csv]
2024-05-02 fix angular velocity speed calculation
    [observations_rewards_times.csv, observations_rewards_times_diagram.xlsx, progress.csv]
2024-05-02 delay + fix angular velocity 2
    [observations_rewards_times.csv, progress.csv]
2024-05-02 fix pole_up <-> angular_velocity
    [observations_rewards_times.csv, progress.csv]
2024-05-07 nächstes 1.5m experiment
    [progress.csv]
2024-05-08 schon wieder eine neue reward funktion
    [observations_rewards_times.csv, progress.csv]
2024-05-09 pole unten bestrafung
    [observations_rewards_times.csv, progress.csv]
2024-05-14 no swing up penalty
    [progress.csv]
2024-05-15 kein position penalty
    [observations_rewards_times.csv, progress.csv]
2024-05-16 deaktivieren der angle velocity pentality
    [observations_rewards_times.csv, progress.csv]
2024-05-16 queue um Experimente neu laufen zu lassen
    [observations_rewards_times.csv, progress.csv]
2024-05-22 aufteilen des vermurksten absatzes
2024-05-22 200k Experimente von Escobar und Simple ausgewertet, die anderen müssen noch durchlaufen
2024-05-23 idea: motor schneller machen
2024-05-23 test, alles läuft wieder
    [observations_rewards_times.csv, progress.csv]
2024-05-24 schon wieder ist das Skript hängen geblieben, immerhin ein Experiment fertig
    [observations_rewards_times.csv, progress.csv]
2024-05-28 die letzten 2 experimente, bei dem letzten ist der gummi kaputt gegangen
    [observations_rewards_times.csv, progress.csv]
2024-05-30 Hinweis auf Episodenlänge + Strafe für nicht in der Mitte bleiben
2024-06-01 endlich langzeit reward ankit fertig
    [observations_rewards_times.csv, progress.csv]
2024-06-04 1m experiment, ich glaube das einzige, was durchgelaufen ist
    [observations_rewards_times.csv, progress.csv]
